gczyghost/Furuta-FPGA-ACG720/mechanical/README.txt

Furuta V8 机械结构工程

assembly/Furuta_ME6025_V8.SLDASM 为SolidWorks原生总装，parts/包含全部21种零件，装配共52个组件。请保持assembly与parts同级目录；若SolidWorks提示旧路径缺失，在打开对话框的“参考”中将文件定位到本包parts目录，同名零件均已提供。不得只上传SLDASM而缺少零件。
assembly/Furuta_ME6025_V8.STEP 为完整总装通用交换文件，无需原生装配外部路径，可供评委直接预览；parts同时保留已有零件STEP。print为三件结构件STL，BOM.csv为部件清单。原生文件建议使用SolidWorks 2025或更高兼容版本。参考电机、编码器、金属摆杆及紧固件作为装配依赖一并保留，不含过程脚本、审计JSON、旧版和重复图片。
本次按现有V8工程原样整理，没有重新修改几何、配合或制造尺寸。
