gczyghost/Furuta-FPGA-ACG720/pcb/README.txt

PCB / 装配图纸

RevF：正式PCB设计资料。design/ 保留嘉立创EDA专业版原生工程及全部关联原理图/PCB文件。
图纸/ 含 RevF 正面（Top）与反面（Bottom）原始导出 SVG 及 PNG。
制造导出/ 保留原版四层 Gerber、BOM、贴片坐标、网表与导出信息。
打开原生工程使用支持 eprj3 文件夹工程的嘉立创EDA专业版，并保持完整目录。
上述内容来自 RevF spacing_20261028 同批冻结导出；未为本次整理改线或重新导出制造数据。

R1：洞洞板装配设计参考。图纸/ 含正面元件/绝缘跳线与反面焊接布线 SVG/PNG。
R1 反面图已镜像；读图时以图中方向、针号和红色1脚标记为准，勿再次随意翻转。
R1 为洞洞板装配图，不是生产PCB Gerber，不能把它当作 RevF 的另一面。
保留已有图纸原件；本次不把照片改称设计图，也不重新验证制造或焊接结果。

SVG 可用浏览器查看和缩放；PNG 便于直接预览。此前提交目录中的 RevC 已由本 RevF 资料替换。
