gczyghost/Furuta-FPGA-ACG720/pcb/RevF/制造导出/Furuta-RevF-Info.txt

工程标题: 		Furuta FPGA Adapter RevF
板子标题: 		Board1
PCB 标题: 		PCB1
时间: 		2026-10-28 18:46:26

板子尺寸: 		3858.3mil x 3858.3mil
板子面积: 		...
铜箔面积: 		顶层 ... 利用率 ...
露铜面积: 		总计 ... 利用率 ...
层: 		总计 24, 铜箔层 4

器件: 		30
封装: 		15
元件: 		总计 178,顶层 178,底层 0
焊盘: 		总计 498, 顶面表贴 349,底面表贴 0,金属化孔 145, 非金属化孔 4
网络: 		总计 109, 未布线 0
测试点: 		网络总数 109, 有测试点的网络 28, 测试点覆盖率 25.69%
 		总计 30, 顶面测试点 30, 底面测试点 0

挖槽区域: 		0
过孔: 		总计 302, 通孔 302, 盲埋孔 0
铺铜区域: 		8
导线长度: 		169294.8mil
