gczyghost/Furuta-FPGA-ACG720/pcb/R1/图纸/R1_反面_已镜像.png

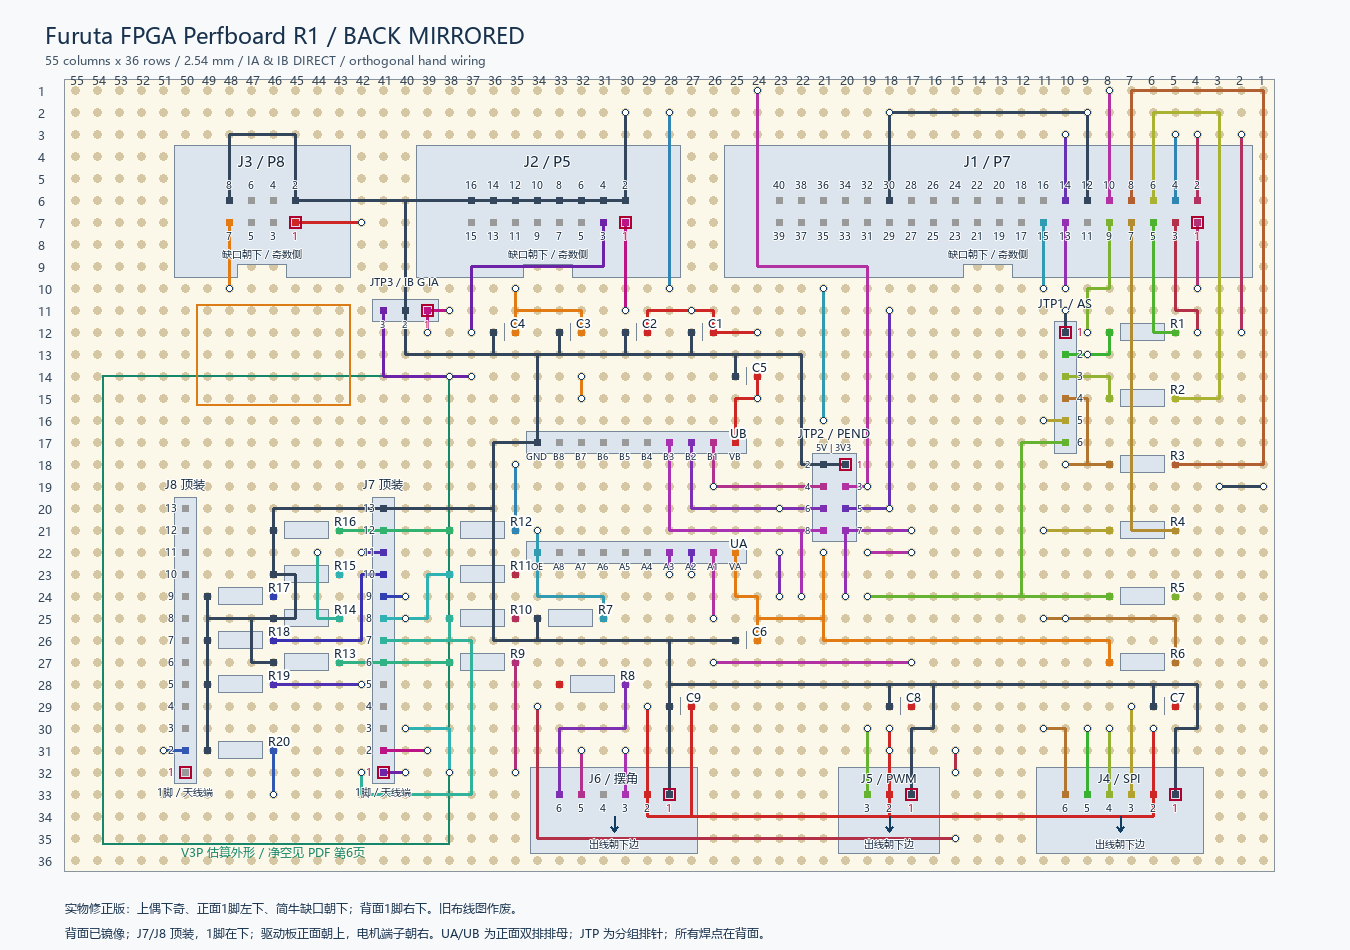
pcb/R1/图纸/R1_反面_已镜像.png
