gczyghost/Furuta-FPGA-ACG720/pcb/R1/图纸/R1_正面.png

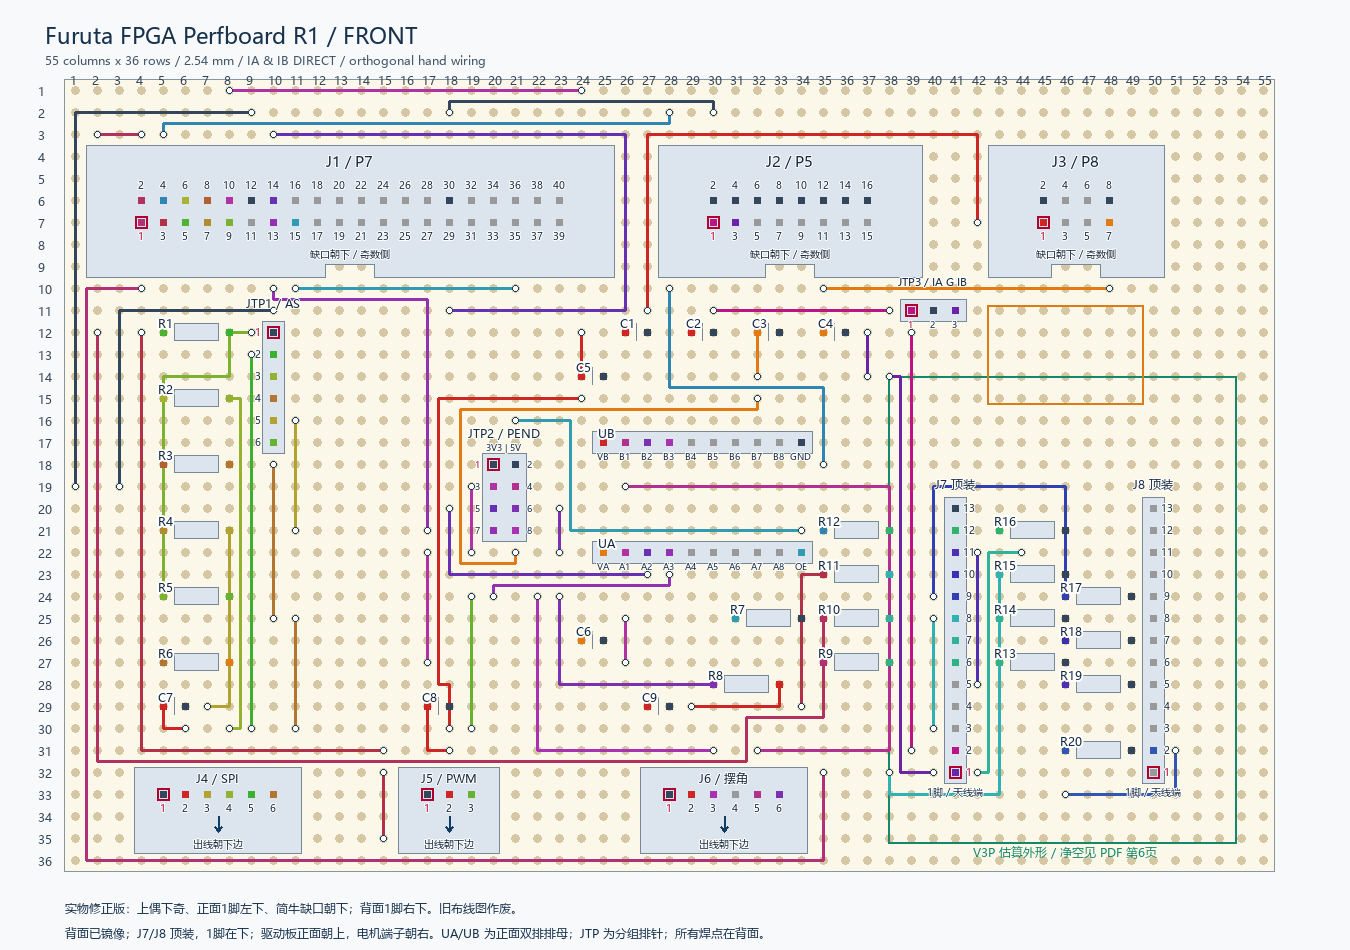
pcb/R1/图纸/R1_正面.png
