gczyghost/Furuta-FPGA-ACG720/pcb/RevF/图纸/RevF_反面.png

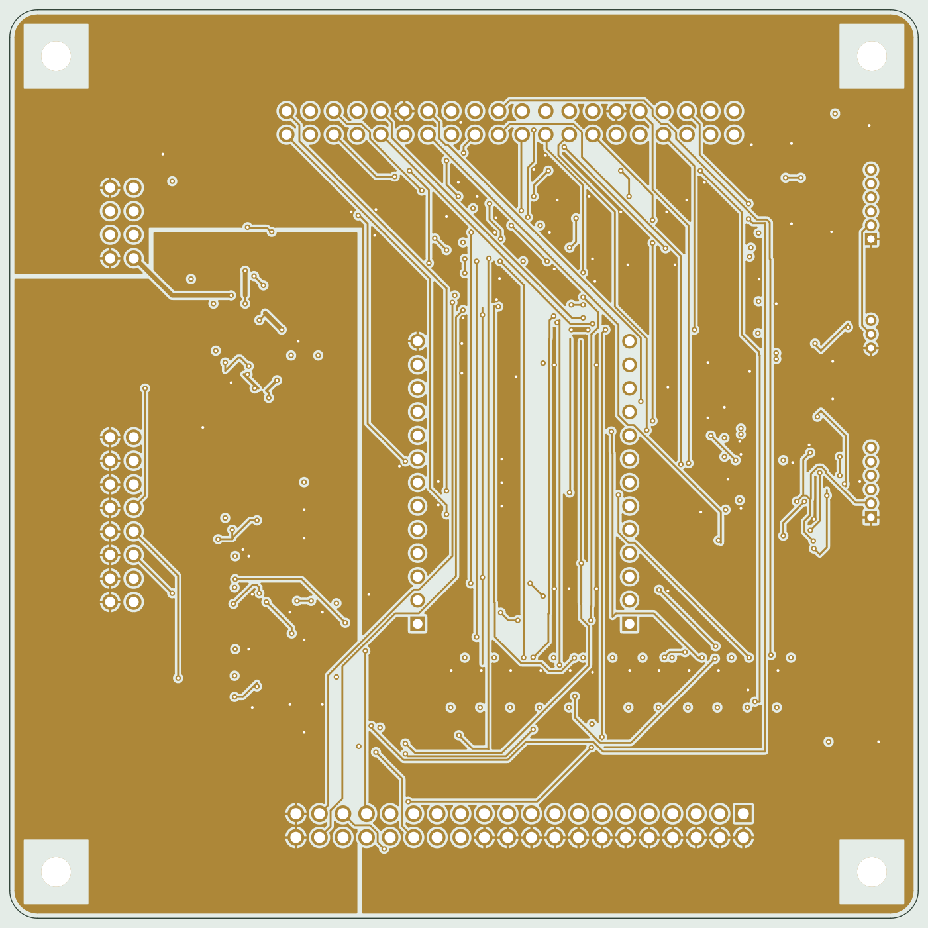
pcb/RevF/图纸/RevF_反面.png
