gczyghost/Furuta-FPGA-ACG720/pcb/RevF/图纸/RevF_正面.png

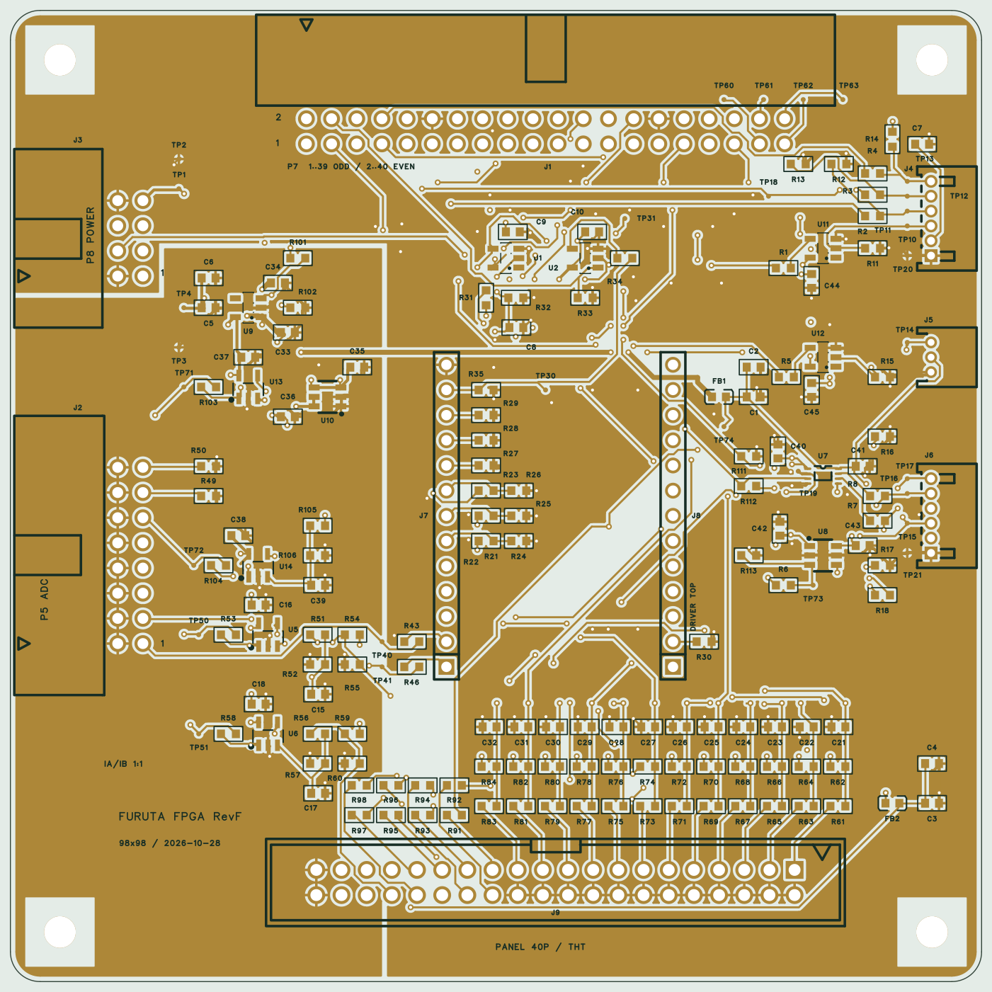
pcb/RevF/图纸/RevF_正面.png
