gczyghost/Furuta-FPGA-ACG720/pcb/RevF/制造导出/Furuta-RevF-BOM.xlsx

No. | Quantity | Comment | Designator | Footprint | Value | Manufacturer Part | Manufacturer | Supplier Part | Supplier
1 | 2 | 10uF | C1,C3 | C0603 | 10uF | CL10A106KP8NNNC | SAMSUNG(三星) | C19702 | LCSC
2 | 20 | 100nF | C2,C4,C6,C7,C9,C10,C15,C16,C17,C18,C34,C37,C38,C39,C40,C41,C42,C43,C44,C45 | C0603 | 100nF | CC0603KRX7R9BB104 | YAGEO(国巨) | C14663 | LCSC
3 | 2 | 2.2uF | C5,C33 | C0603 | 2.2uF | CL10A225KP8NNNC | SAMSUNG(三星) | C1607 | LCSC
4 | 1 | 1nF | C8 | C0603 | 1nF | CC0603KRX7R9BB102 | YAGEO(国巨) | C100040 | LCSC
5 | 12 | 10nF | C21,C22,C23,C24,C25,C26,C27,C28,C29,C30,C31,C32 | C0603 | 10nF | CC0603KRX7R9BB103 | YAGEO(国巨) | C100042 | LCSC
6 | 2 | 1uF | C35,C36 | C0603 | 1uF | CL10B105KA8NNNC | SAMSUNG(三星) | C29936 | LCSC
7 | 2 | BLM18AG601SN1D | FB1,FB2 | L0603 |  | BLM18AG601SN1D | muRata(村田) | C19330 | LCSC
8 | 1 | B-3000R40P-0110 | J1 | IDC-TH_40P-P2.54_300R-40P |  | B-3000R40P-0110 | Ckmtw(灿科盟) | C146628 | LCSC
9 | 1 | B-3000R16P-0110 | J2 | IDC-TH_16P-P2.54_300R-16P |  | B-3000R16P-0110 | Ckmtw(灿科盟) | C146623 | LCSC
10 | 1 | B-3000R08P-0110 | J3 | IDC-TH_8P-P2.54_300R-8P |  | B-3000R08P-0110 | Ckmtw(灿科盟) | C146630 | LCSC
11 | 2 | S6B-ZR(LF)(SN) | J4,J6 | CONN-TH_S6B-ZR-3.4-LF-SN |  | S6B-ZR(LF)(SN) | JST | C265407 | LCSC
12 | 1 | S3B-ZR(LF)(SN) | J5 | CONN-TH_S3B-ZR-LF-SN |  | S3B-ZR(LF)(SN) | JST | C157927 | LCSC
13 | 2 | HX PZ2.54-1x13P ZZ | J7,J8 | HDR-TH_13P-P2.54-V-M_2 |  | HX PZ2.54-1x13P ZZ | hanxia(韩下) | C42372505 | LCSC
14 | 1 | B-3000S40P-0110 | J9 | CONN-TH_300S-40P |  | B-3000S40P-0110 | Ckmtw(灿科盟) | C132439 | LCSC
15 | 18 | 33Ω | R1,R2,R3,R4,R5,R6,R7,R8,R21,R22,R23,R34,R43,R46,R53,R58,R103,R104 | R0603 | 33Ω | 0603WAF330JT5E | UNI-ROYAL(厚声) | C23140 | LCSC
16 | 14 | 100kΩ | R11,R12,R13,R15,R16,R17,R33,R49,R50,R55,R60,R102,R111,R113 | R0603 | 100kΩ | 0603WAF1003T5E | UNI-ROYAL(厚声) | C25803 | LCSC
17 | 25 | 10kΩ | R14,R18,R24,R25,R26,R27,R28,R29,R30,R32,R35,R62,R64,R66,R68,R70,R72,R74,R76,R78,R80,R82,R84,R101,R112 | R0603 | 10kΩ | 0603WAF1002T5E | UNI-ROYAL(厚声) | C25804 | LCSC
18 | 21 | 1kΩ | R31,R61,R63,R65,R67,R69,R71,R73,R75,R77,R79,R81,R83,R91,R92,R93,R94,R95,R96,R97,R98 | R0603 | 1kΩ | 0603WAF1001T5E | UNI-ROYAL(厚声) | C21190 | LCSC
19 | 2 | 3.3kΩ | R51,R56 | R0603 | 3.3kΩ | 0603WAF3301T5E | UNI-ROYAL(厚声) | C22978 | LCSC
20 | 2 | 33kΩ | R52,R57 | R0603 | 33kΩ | 0603WAF3302T5E | UNI-ROYAL(厚声) | C4216 | LCSC
21 | 2 | 27kΩ | R54,R59 | R0603 | 27kΩ | 0603WAF2702T5E | UNI-ROYAL(厚声) | C22967 | LCSC
22 | 2 | 10kΩ | R105,R106 | R0603 | 10kΩ | RT0603BRD0710KL | YAGEO(国巨) | C95204 | LCSC
23 | 3 | SN74LVC1G17DBVR | U1,U11,U12 | SOT-23-5_L3.0-W1.7-P0.95-LS2.8-BR |  | SN74LVC1G17DBVR | TI(德州仪器) | C7836 | LCSC
24 | 1 | SN74LVC1G08DBVR | U2 | SOT-23-5_L3.0-W1.7-P0.95-LS2.8-BR |  | SN74LVC1G08DBVR | TI(德州仪器) | C7666 | LCSC
25 | 4 | TLV9061IDBVR | U5,U6,U13,U14 | SOT-23-5_L3.0-W1.7-P0.95-LS2.8-BL |  | TLV9061IDBVR | TI(德州仪器) | C398358 | LCSC
26 | 1 | SN74LVC2T45DCUR | U7 | VSSOP-8_L2.4-W2.1-P0.50-LS3.2-BR |  | SN74LVC2T45DCUR | TI(德州仪器) | C15741 | LCSC
27 | 1 | SN74LVC1T45DBVR | U8 | SOT-23-6_L2.9-W1.6-P0.95-LS2.8-BR |  | SN74LVC1T45DBVR | TI(德州仪器) | C7843 | LCSC
28 | 1 | LP5907MFX-3.3/NOPB | U9 | SOT-23-5_L3.0-W1.7-P0.95-LS2.8-BR |  | LP5907MFX-3.3/NOPB | TI(德州仪器) | C80670 | LCSC
29 | 1 | REF3425IDBVR | U10 | SOT-23-6_L2.9-W1.6-P0.95-LS2.8-BR |  | REF3425IDBVR | TI(德州仪器) | C187836 | LCSC
