gczyghost/Furuta-FPGA-ACG720/mechanical/assembly/Furuta_ME6025_V8.STEP

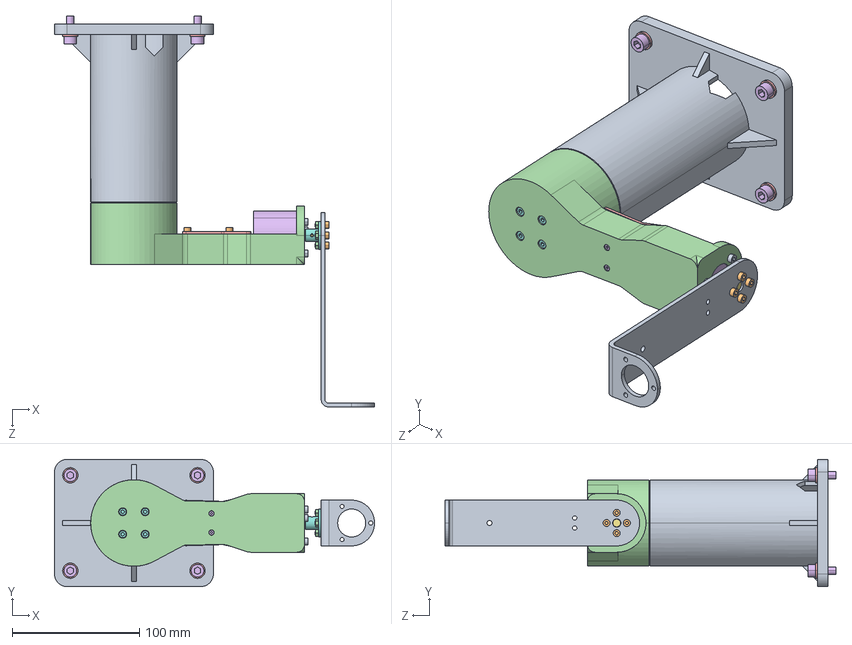
[picture p5: CAD file, 2026-11-03]
mechanical/assembly/Furuta_ME6025_V8.STEP
251.7 x 100.0 x 307.4 mm
V8_01_Integrated_Base_PLA
ME6025_Reference
V8_02_Inverted_Arm_PLA
V8_03_Underside_Service_Cover_PLA
06_OID3806D_Reference
07_Encoder_Shaft_Reference
08_Flange_Coupler_D6
Metal_Pendulum_Existing
V2_05_Adapter_PCB_20x20
V2_10_XH5P_SideEntry_ENVELOPE
V2_11_ZH6P_SideEntry_ENVELOPE
V2_09_M2_Standoff_FF_5 x 2
H_M2x12_SocketScrew x 2
H_M2x4_SocketScrew x 2
H_M3x12_SocketScrew x 4
H_M3x10_SocketScrew x 7
H_M3x8_SocketScrew x 8
V8_H_M3_Heatset_OD4_L5 x 4
H_M3_HexNut x 4
H_M6_Washer x 4
H_M6x16_SocketScrew x 4
