gczyghost/Furuta-FPGA-ACG720/mechanical/parts/08_Flange_Coupler_D6.STEP

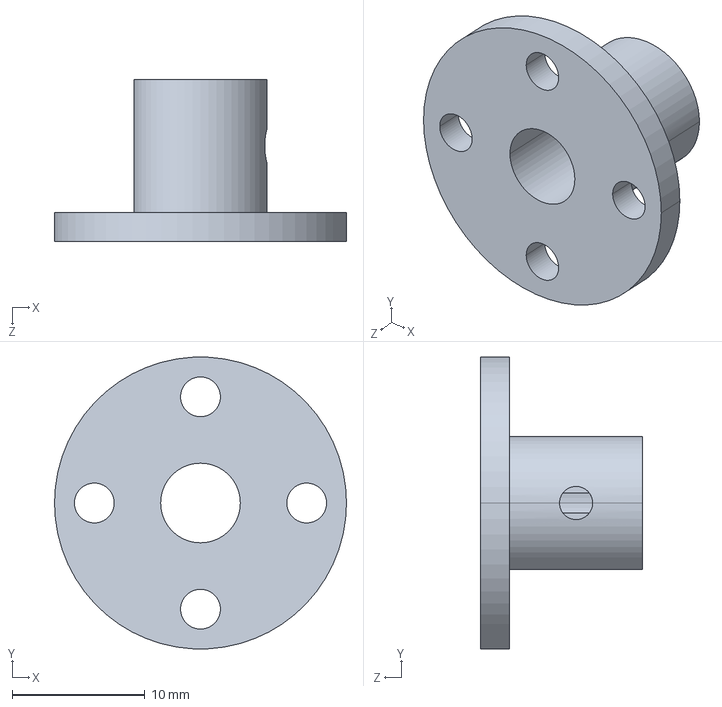
[picture p6: CAD file, 2026-11-03]
mechanical/parts/08_Flange_Coupler_D6.STEP
22.0 x 22.0 x 12.2 mm
