gczyghost/Furuta-FPGA-ACG720/mechanical/print/Furuta_PLA_layout.3mf

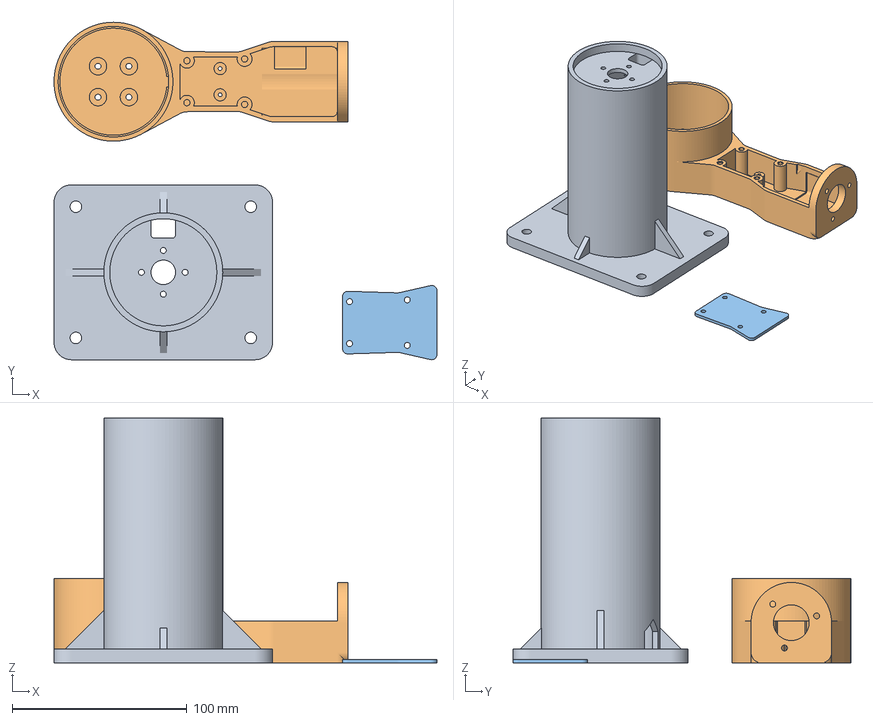
[picture p7: CAD file, 2026-11-03]
mechanical/print/Furuta_PLA_layout.3mf
219.0 x 193.0 x 140.0 mm
V8_01_Integrated_Base_PLA
V8_02_Inverted_Arm_PLA
V8_03_Underside_Service_Cover_PLA
