gczyghost/Furuta-FPGA-ACG720/mechanical/parts/V8_02_Inverted_Arm_PLA.STEP

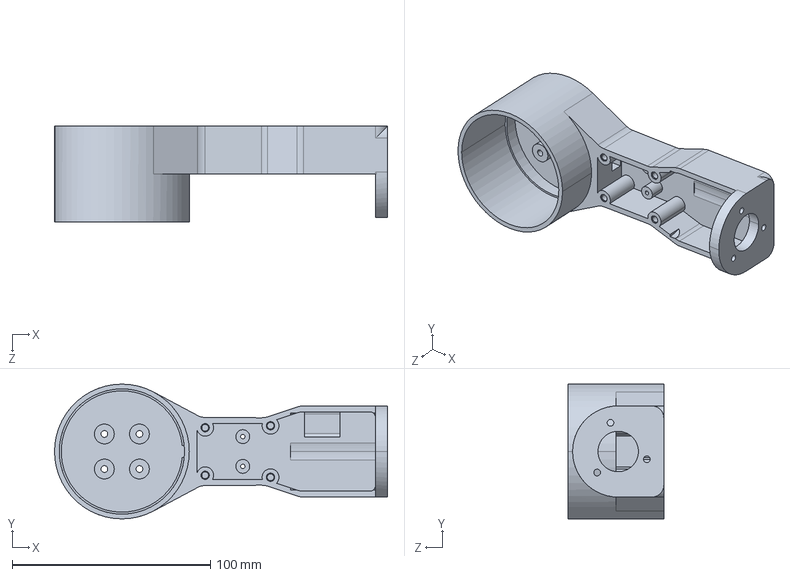
[picture p8: CAD file, 2026-11-03]
mechanical/parts/V8_02_Inverted_Arm_PLA.STEP
168.0 x 68.0 x 48.2 mm
