gczyghost/Furuta-FPGA-ACG720/mechanical/parts/ME6025_Reference.STEP

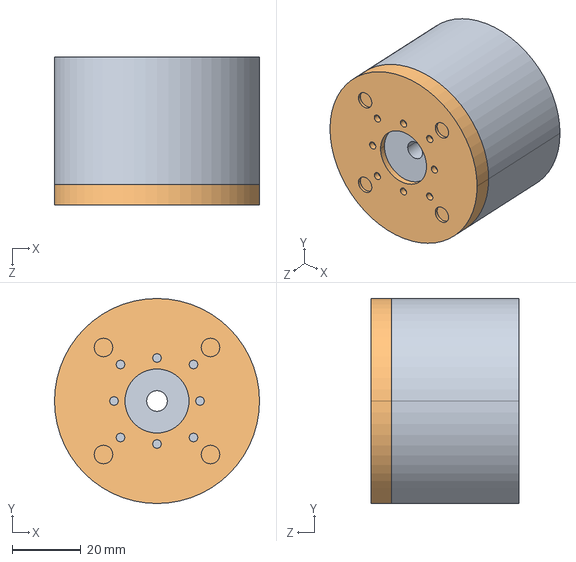
[picture p9: CAD file, 2026-11-03]
mechanical/parts/ME6025_Reference.STEP
59.6 x 59.6 x 43.0 mm
