gczyghost/Furuta-FPGA-ACG720/mechanical/parts/V2_11_ZH6P_SideEntry_ENVELOPE.STEP

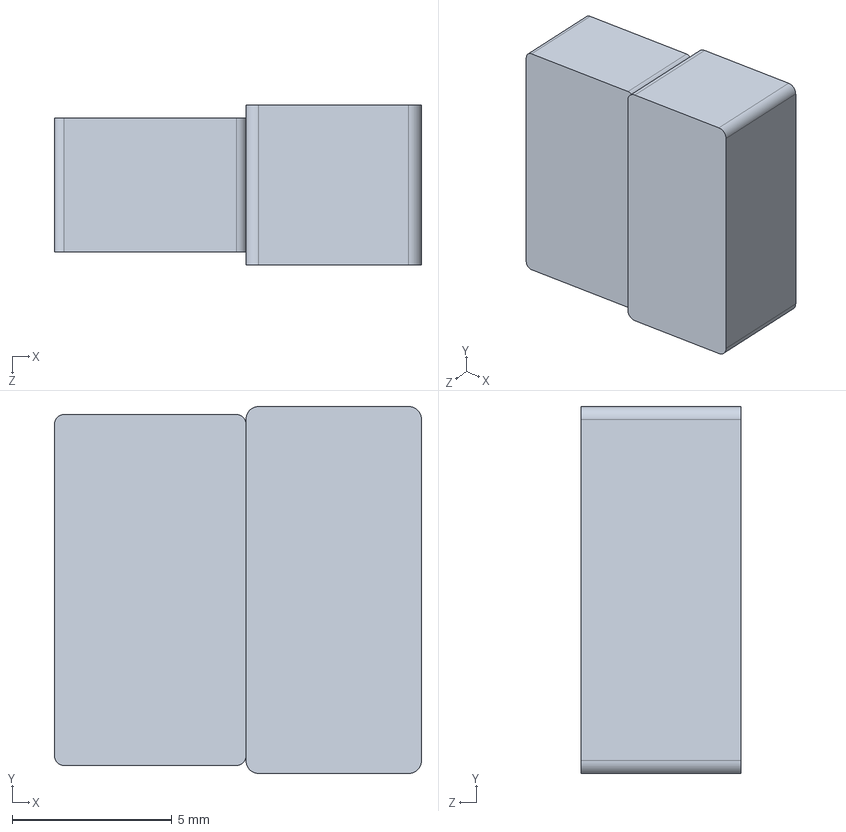
[picture p10: CAD file, 2026-11-03]
mechanical/parts/V2_11_ZH6P_SideEntry_ENVELOPE.STEP
11.5 x 11.5 x 5.00 mm
