gczyghost/Furuta-FPGA-ACG720/mechanical/parts/V8_03_Underside_Service_Cover_PLA.STEP

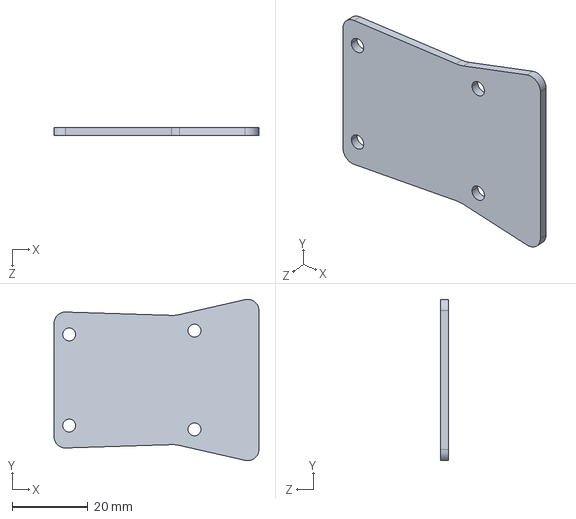
[picture p11: CAD file, 2026-11-03]
mechanical/parts/V8_03_Underside_Service_Cover_PLA.STEP
54.0 x 42.5 x 2.00 mm
