gczyghost/Furuta-FPGA-ACG720/mechanical/parts/Metal_Pendulum_Existing.SLDPRT

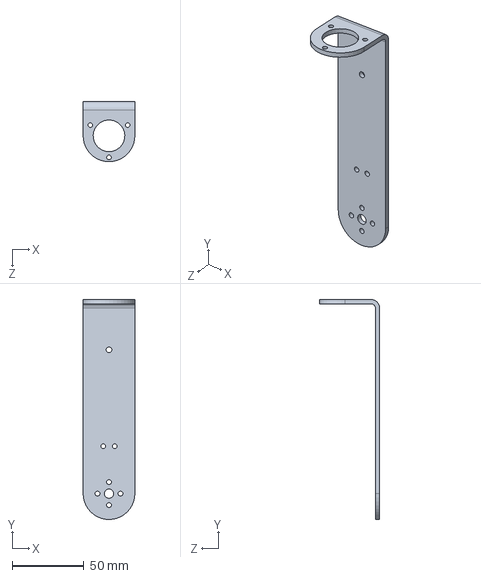
[picture p12: CAD file, 2026-11-03]
mechanical/parts/Metal_Pendulum_Existing.SLDPRT
36.0 x 153.0 x 42.0 mm
