gczyghost/Furuta-FPGA-ACG720/mechanical/parts/V2_09_M2_Standoff_FF_5.STEP

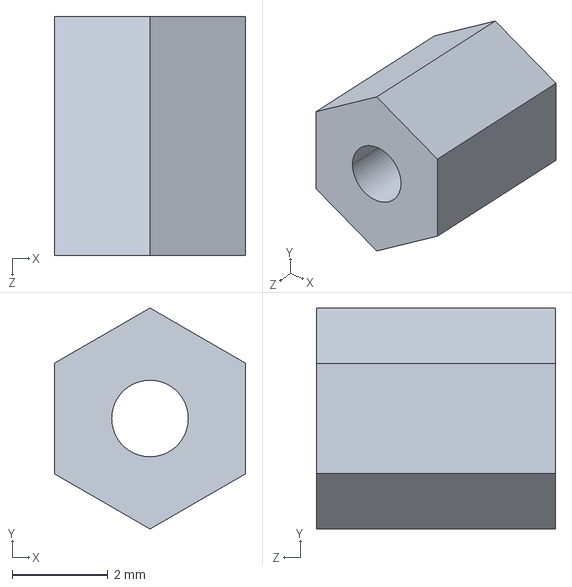
[picture p13: CAD file, 2026-11-03]
mechanical/parts/V2_09_M2_Standoff_FF_5.STEP
4.00 x 4.62 x 5.00 mm
