gczyghost/Furuta-FPGA-ACG720/mechanical/parts/07_Encoder_Shaft_Reference.STEP

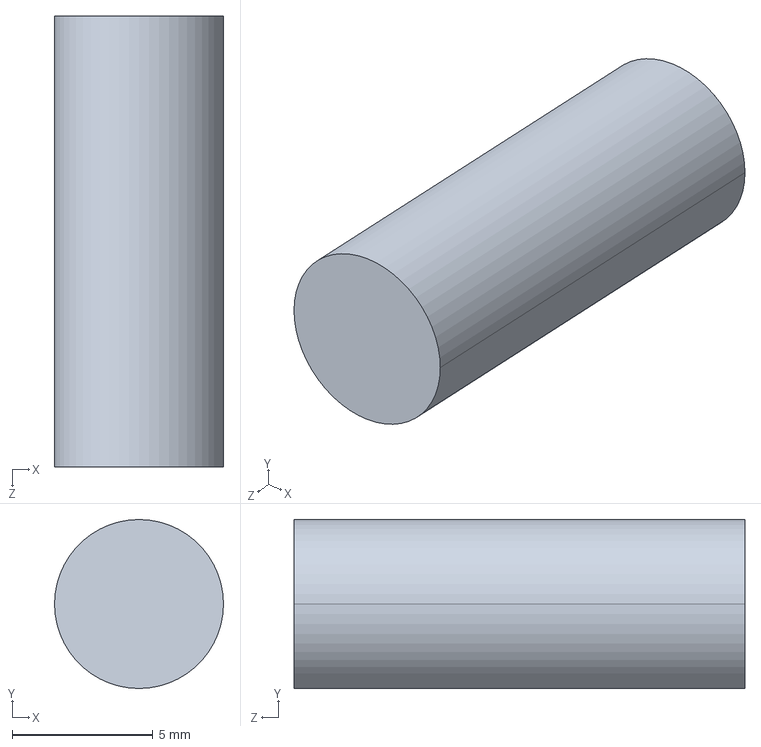
[picture p14: CAD file, 2026-11-03]
mechanical/parts/07_Encoder_Shaft_Reference.STEP
6.00 x 6.00 x 16.0 mm
