gczyghost/Furuta-FPGA-ACG720/mechanical/parts/V2_05_Adapter_PCB_20x20.STEP

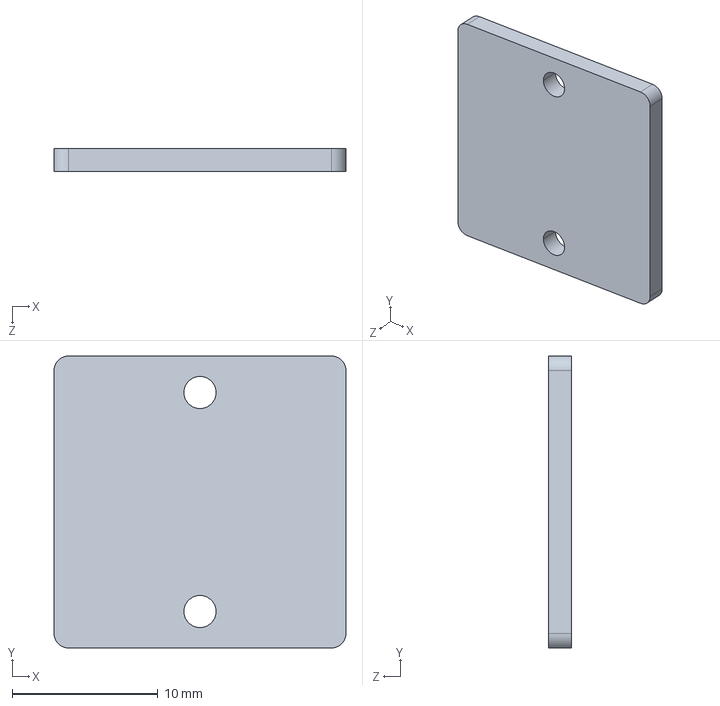
[picture p15: CAD file, 2026-11-03]
mechanical/parts/V2_05_Adapter_PCB_20x20.STEP
20.0 x 20.0 x 1.60 mm
