gczyghost/Furuta-FPGA-ACG720/mechanical/parts/V8_01_Integrated_Base_PLA.STEP

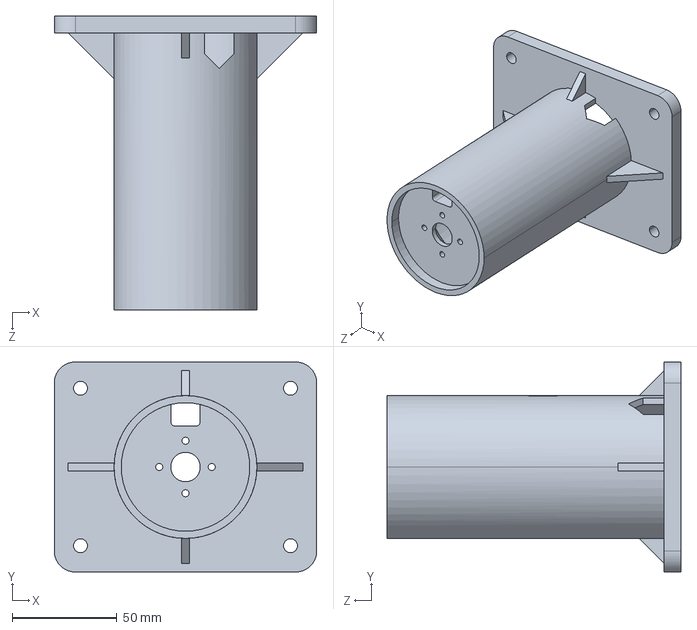
[picture p16: CAD file, 2026-11-03]
mechanical/parts/V8_01_Integrated_Base_PLA.STEP
125.0 x 100.0 x 140.0 mm
