gczyghost/Furuta-FPGA-ACG720/mechanical/parts/06_OID3806D_Reference.STEP

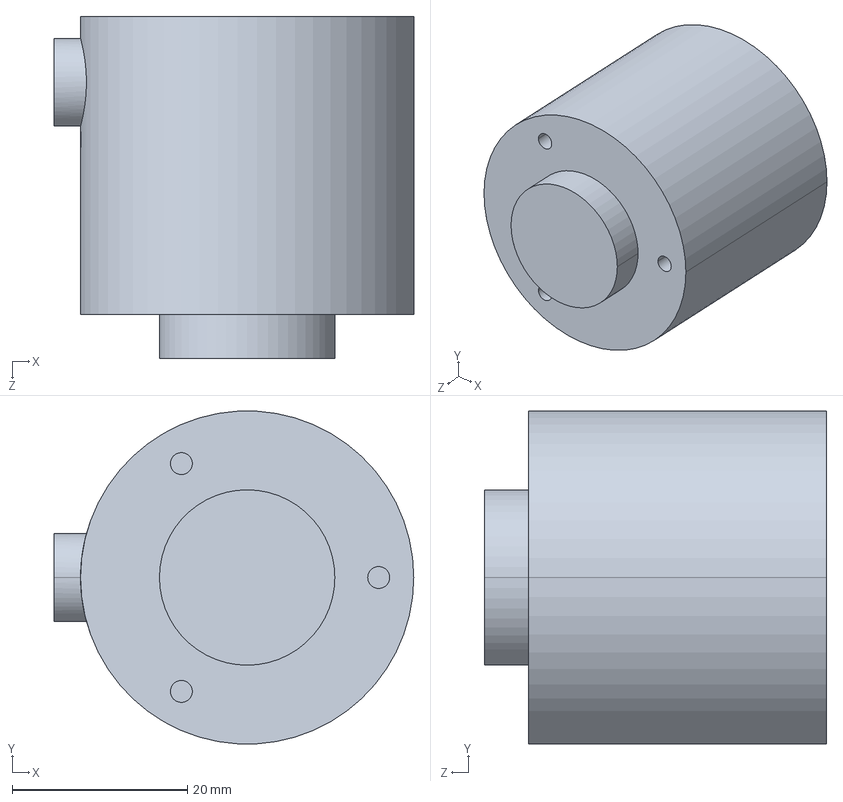
[picture p17: CAD file, 2026-11-03]
mechanical/parts/06_OID3806D_Reference.STEP
41.0 x 37.9 x 39.0 mm
