gczyghost/Furuta-FPGA-ACG720/mechanical/parts/V8_H_M3_Heatset_OD4_L5.STEP

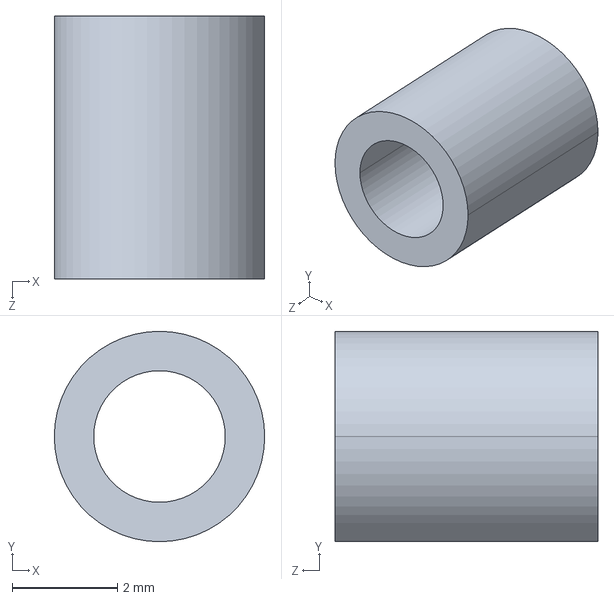
[picture p18: CAD file, 2026-11-03]
mechanical/parts/V8_H_M3_Heatset_OD4_L5.STEP
4.00 x 4.00 x 5.00 mm
