gczyghost/Furuta-FPGA-ACG720/mechanical/parts/V2_10_XH5P_SideEntry_ENVELOPE.STEP

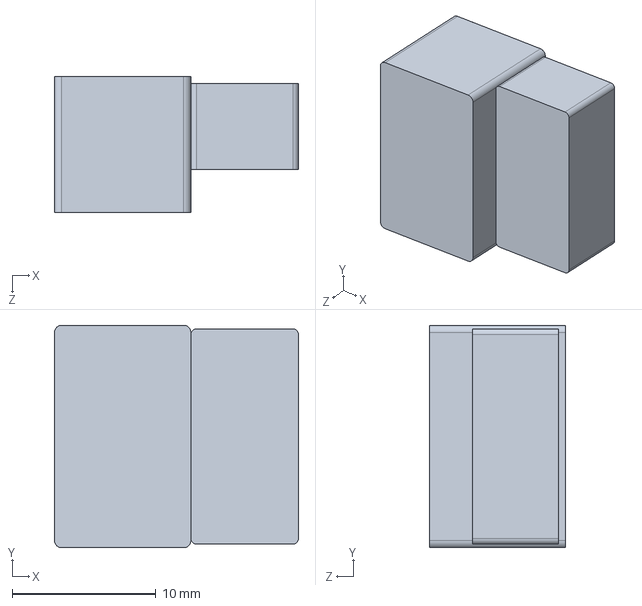
[picture p19: CAD file, 2026-11-03]
mechanical/parts/V2_10_XH5P_SideEntry_ENVELOPE.STEP
17.0 x 15.5 x 9.50 mm
