gczyghost/Furuta-FPGA-ACG720/mechanical/parts/H_M2x12_SocketScrew.SLDPRT

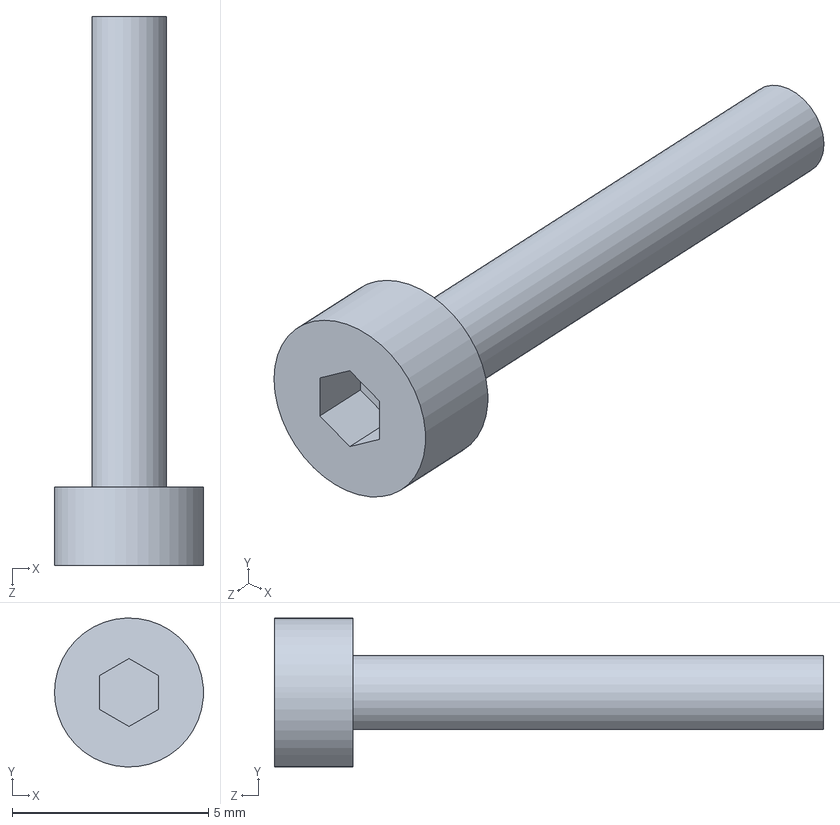
[picture p20: CAD file, 2026-11-03]
mechanical/parts/H_M2x12_SocketScrew.SLDPRT
3.80 x 3.80 x 14.0 mm
