gczyghost/Furuta-FPGA-ACG720/(list of files, cad)

Other CAD files:
mechanical/parts/H_M3_HexNut.SLDPRT
mechanical/parts/H_M6_Washer.SLDPRT
mechanical/assembly/Furuta_ME6025_V8.SLDASM
mechanical/parts/06_OID3806D_Reference.SLDPRT
mechanical/parts/07_Encoder_Shaft_Reference.SLDPRT
mechanical/parts/08_Flange_Coupler_D6.SLDPRT
mechanical/parts/H_M2x4_SocketScrew.SLDPRT
mechanical/parts/H_M3x10_SocketScrew.SLDPRT
mechanical/parts/H_M3x12_SocketScrew.SLDPRT
mechanical/parts/H_M3x8_SocketScrew.SLDPRT
mechanical/parts/H_M6x16_SocketScrew.SLDPRT
mechanical/parts/ME6025_Reference.SLDPRT
mechanical/parts/V2_05_Adapter_PCB_20x20.SLDPRT
mechanical/parts/V2_09_M2_Standoff_FF_5.SLDPRT
mechanical/parts/V2_10_XH5P_SideEntry_ENVELOPE.SLDPRT
mechanical/parts/V2_11_ZH6P_SideEntry_ENVELOPE.SLDPRT
mechanical/parts/V8_01_Integrated_Base_PLA.SLDPRT
mechanical/parts/V8_02_Inverted_Arm_PLA.SLDPRT
mechanical/parts/V8_03_Underside_Service_Cover_PLA.SLDPRT
mechanical/parts/V8_H_M3_Heatset_OD4_L5.SLDPRT
mechanical/print/V8_01_Integrated_Base_PLA.STL
mechanical/print/V8_02_Inverted_Arm_PLA.STL
mechanical/print/V8_03_Underside_Service_Cover_PLA.STL
