gczyghost/Furuta-FPGA-ACG720/gui/source/host/pc_host/fpga_simulator.py

"""Offline protocol peer, never opens a port. Plant replay is labelled simulation."""
import csv
from pathlib import Path
import time
import math
from .fpga_protocol import encode, StreamDecoder, MAGIC, Calibration, signed

class SimSerial:
    def __init__(self,port=None,baudrate=None,timeout=.01,write_timeout=None,clock=time.monotonic,multiturn=False,live_servo=False,cold_snapshot=False,bootstrap_v4=False,postcommit_health='valid',postcommit_delay=0.):
        if bootstrap_v4 and not multiturn:raise ValueError('Bootstrap v4 requires multiturn')
        if postcommit_health not in ('valid','missing','stale','off_not_ready'):raise ValueError('Unknown health fixture')
        self.bootstrap_v4=bootstrap_v4;self.postcommit_health=postcommit_health
        if not 0<=postcommit_delay<=10:raise ValueError('Invalid postcommit sample delay')
        self.postcommit_delay=postcommit_delay;self.committed_at=None
        # Fault-injection fixture for B01's frozen v4 cold telemetry, not a model
        # of how CAL or power should recover the hardware.
        if cold_snapshot and not multiturn:raise ValueError('Cold v4 fixture requires multiturn')
        self.cold_snapshot=cold_snapshot
        if live_servo and not multiturn:raise ValueError('SV27 simulation requires MOT2')
        self.live_servo=live_servo
        self.multiturn=multiturn;self.frame_turns=0;self.keep_session=False;self.session_started=None
        self.clock=clock;self.timeout=timeout;self.started=clock();self.last_snapshot=0.;self.last_hb=0.
        self.buffer=bytearray();self.decoder=StreamDecoder();self.seq=None;self.tx_seq=0
        self.words=[0]*8;self.mask=0;self.calibrated=False;self.run=False;self.fault=False;self.reason=0
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
